Abe57/Encore-FE-WRO2025/v-photos/README.md

Fotos del Vehículo
====
### Frontal: 
imagen
### Trasera: 
imagen
### Superior (Segundo nivel): 
imagen
### Inferior: 
imagen
### Lateral 1: 
imagen
### Lateral 2: 
imagen
