Abe57/Encore-FE-WRO2025/schemes/README.md

Diagramas electromecánicos
====

Este directorio contiene el diagrama electrónico y mecánico del vehículo.

### Diagrama gráfico

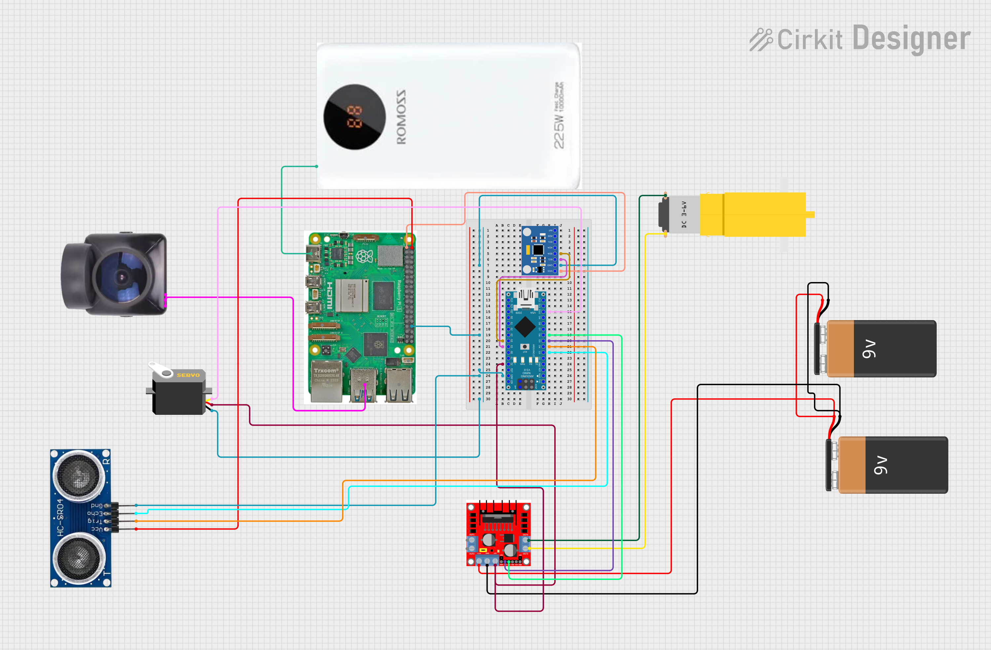
[picture p26: schemes/Diagrama-cirkit.png]
Diagrama gráfico


### Diagrama esquemático

Diagrama esquemático
