Abe57/Encore-FE-WRO2025/docs/README.md

Documentos
=====
Este directorio contiene el diario de ingeniería y la lista de componentes.
