Abe57/Encore-FE-WRO2025/t-photos/README.md

Fotos del Equipo
====

Foto del equipo **(De izquierda a derecha: Jose Heraldez, Abel Herrera, Pablo Gonzalez)**

Imagen Grupal Foto Grupal
Somos un grupo de amigos apasionados por la robotica y que cursamos el mismo grado, llevamos en las WRO desde 2023, este año vamos con el objetivo de sacar nuestro máximo potencial.

### José Heráldez
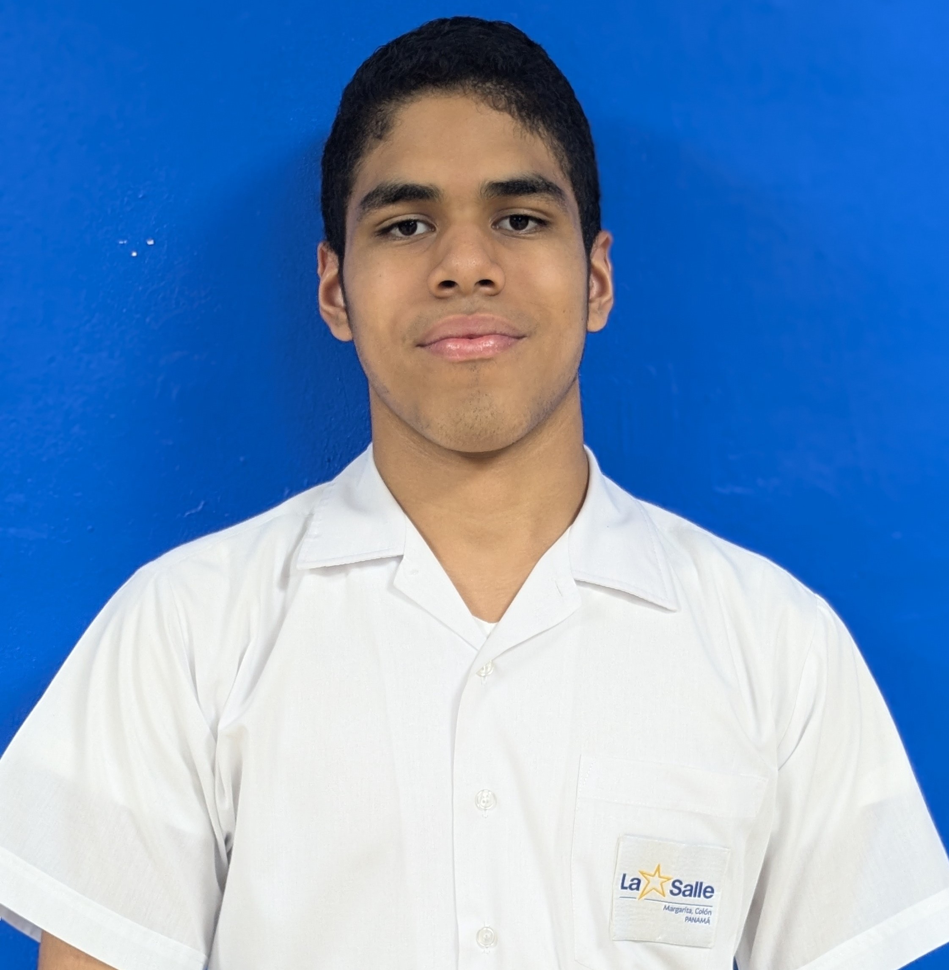
[picture p27: t-photos/Jose-Heraldez.jpg]
José Heráldez


Es el coordinador y el apoyo general, se encarga de mantener toda la organización, reuniones, recopilación de información y redacción, es calmado, proactivo y tiene experiencia en gestión de proyectos y le gusta mantener el orden. 

### Abel Herrera
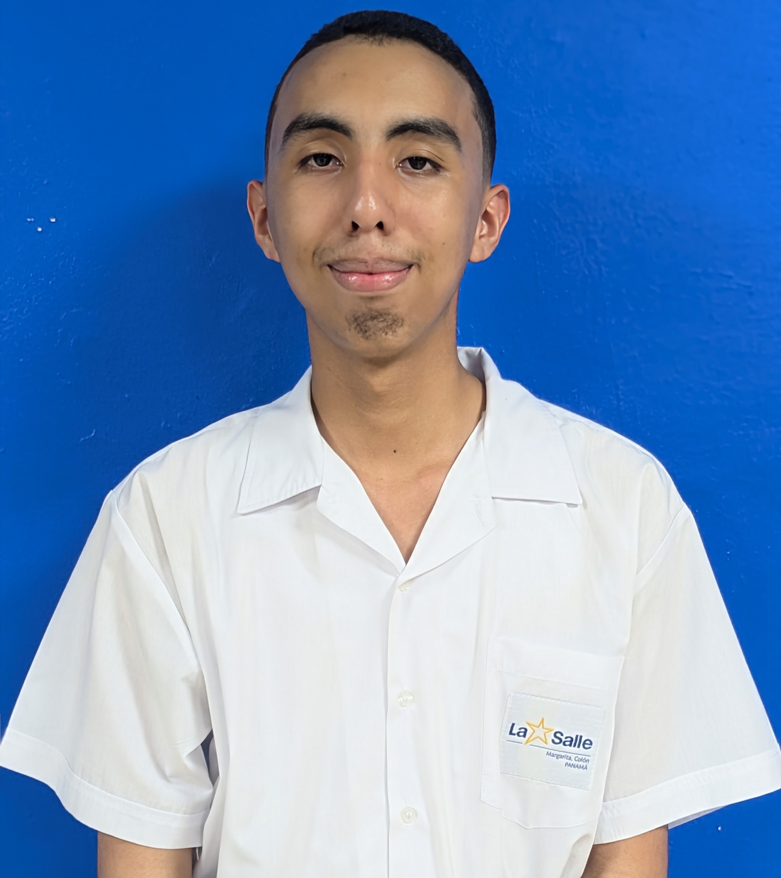
[picture p28: t-photos/Abel-Herrera.jpg]
Abel Herrera

Es el programador del equipo, está enfocado en todo el codigo y la lógica detras de este. Le apaciona la resolucion de problemas y aprender. 

### Pablo González
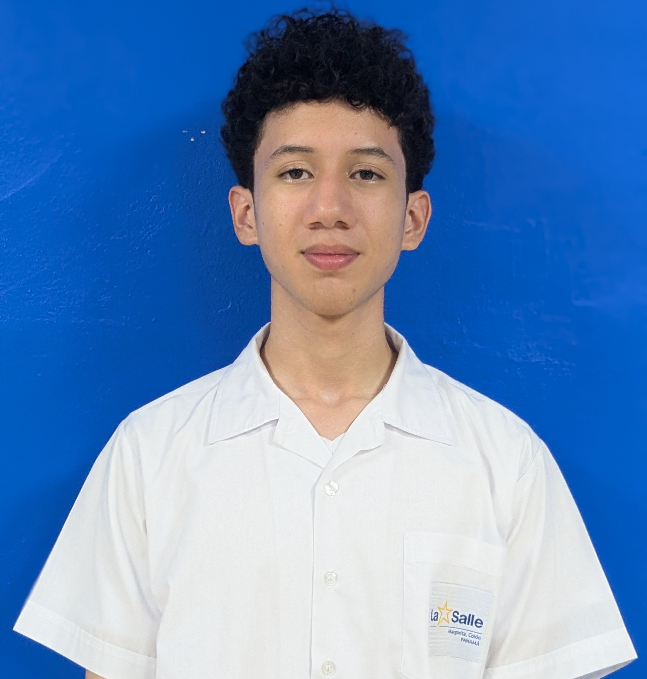
[picture p29: t-photos/Pablo-Gonzalez.jpg]
Pablo González

Es el encargado de la parte mecánica y electrónica del robot, le gusta mantener el equipo motivado, dormir, escuchar música y le apasiona ingeniería. 

## Foto divertida

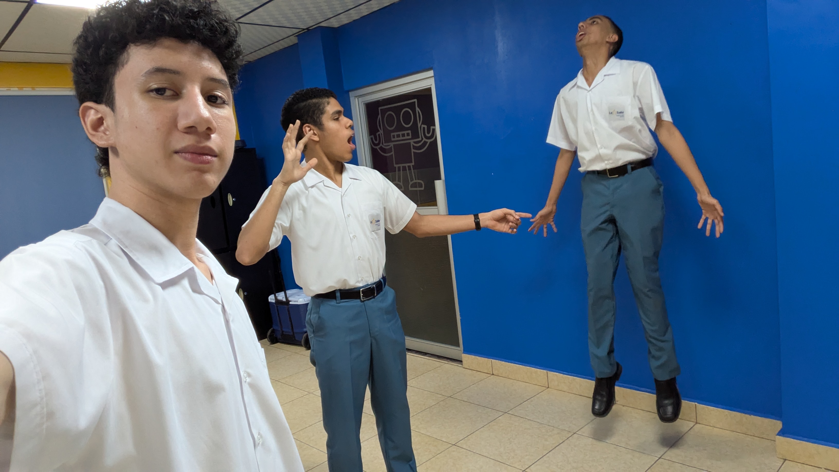
[picture p30: t-photos/Funnypic.jpg]
Foto divertida
