Abe57/Encore-FE-WRO2025/other/Diagrama-grafico(primer-modelo).png

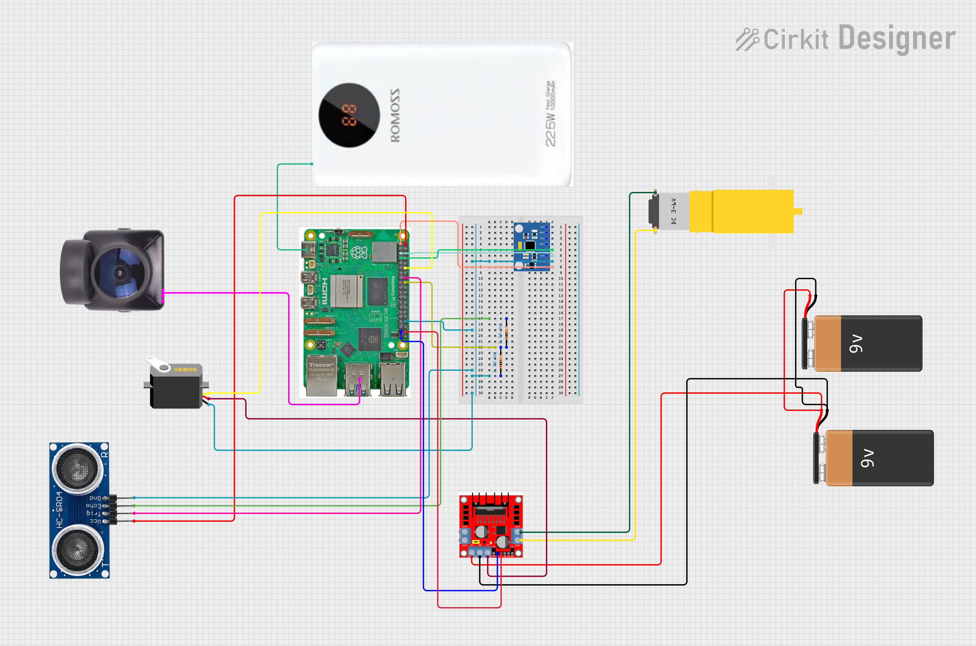
other/Diagrama-grafico(primer-modelo).png
