Abe57/Encore-FE-WRO2025/other/ENCORE-DIAGRAMA-ELECTROMECANICO(primer-modelo).png

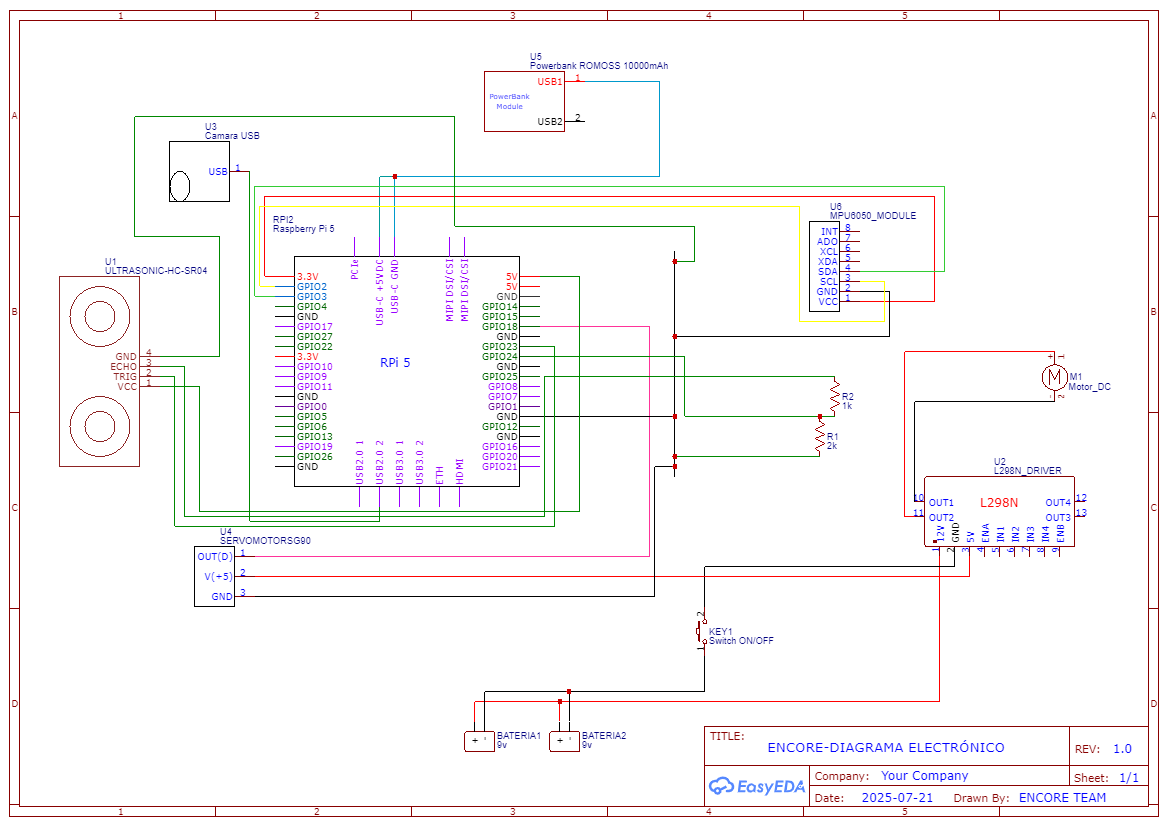
other/ENCORE-DIAGRAMA-ELECTROMECANICO(primer-modelo).png
