Abe57/Encore-FE-WRO2025/other/primermodelo.jpg

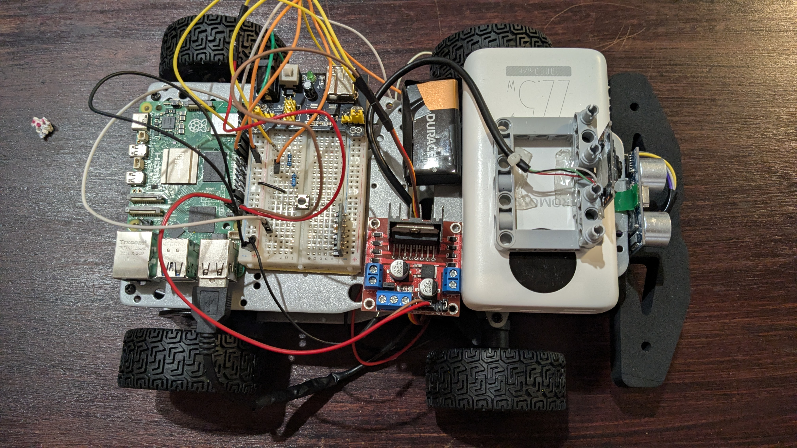
other/primermodelo.jpg
