Abe57/Encore-FE-WRO2025/(commit log)

2025-06-30 Distance Detection Thread
2025-08-07 Moved sensor processing to external microcontroller
2025-08-07 Create Lista de materiales-ENCORE.xlsx
2025-09-30 Improved sensor handling and command processing; Update README.md
